billgilbert7000/4164-41256-tester/README.md

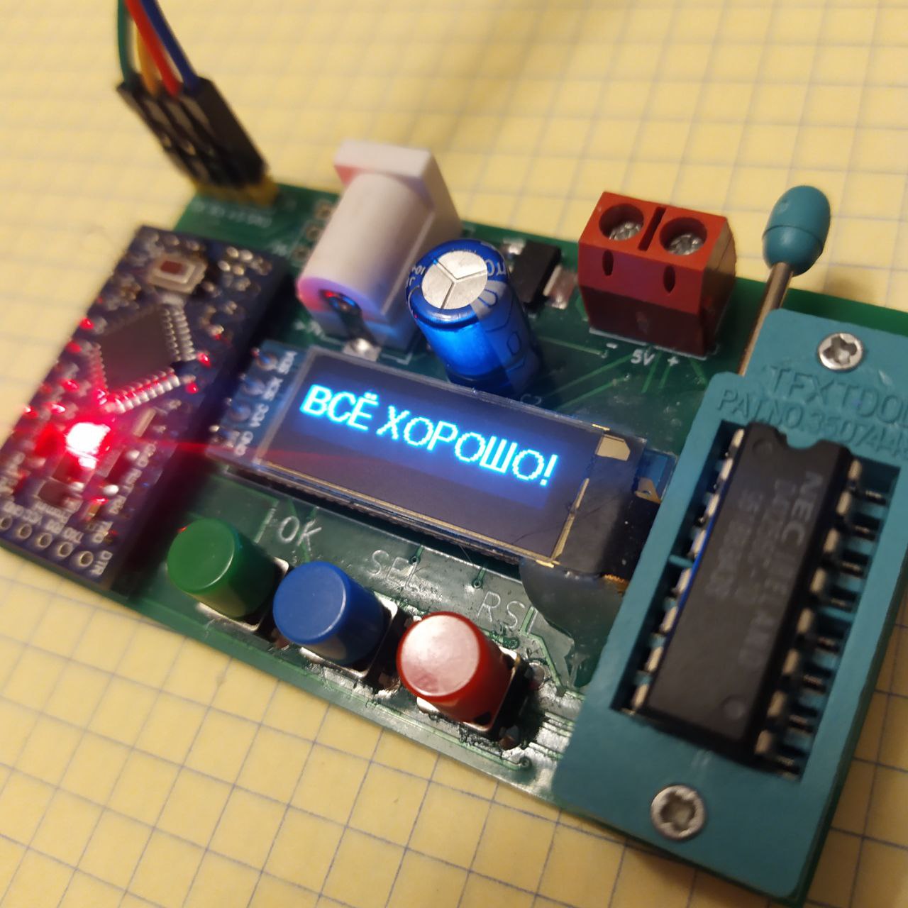
[picture p1: pics/04.jpg]

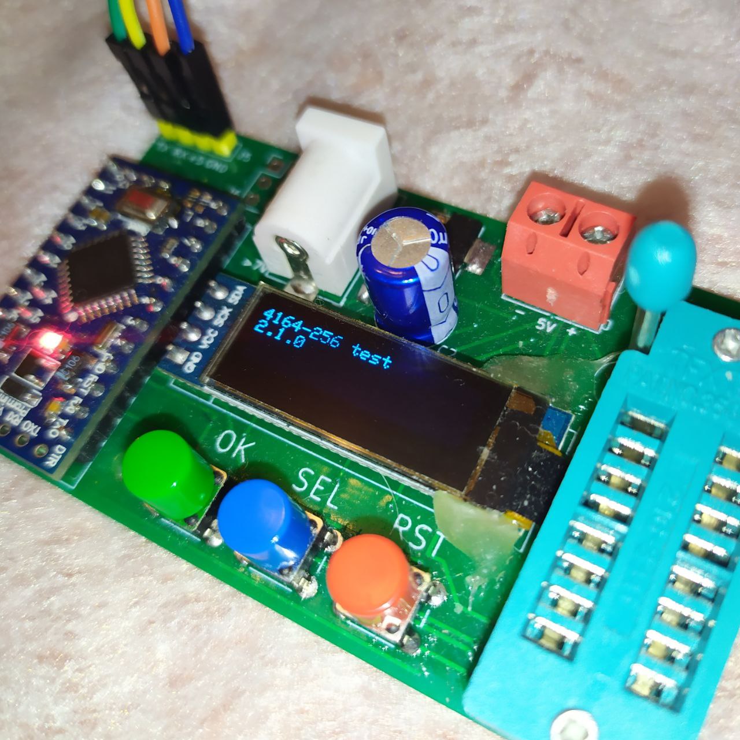
[picture p2: pics/05.jpg]

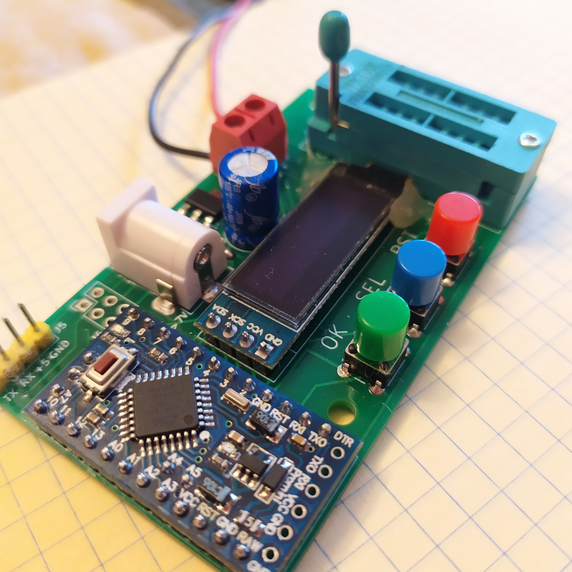
[picture p3: pics/01.jpg]

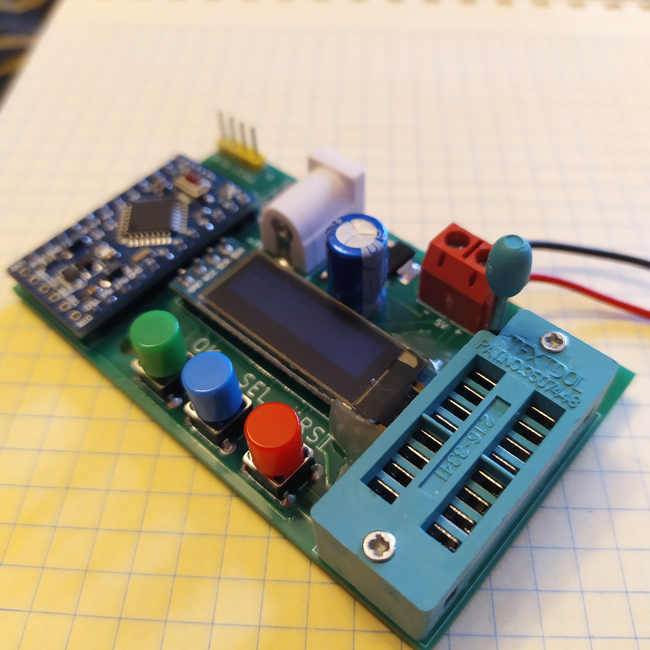
[picture p4: pics/02.jpg]

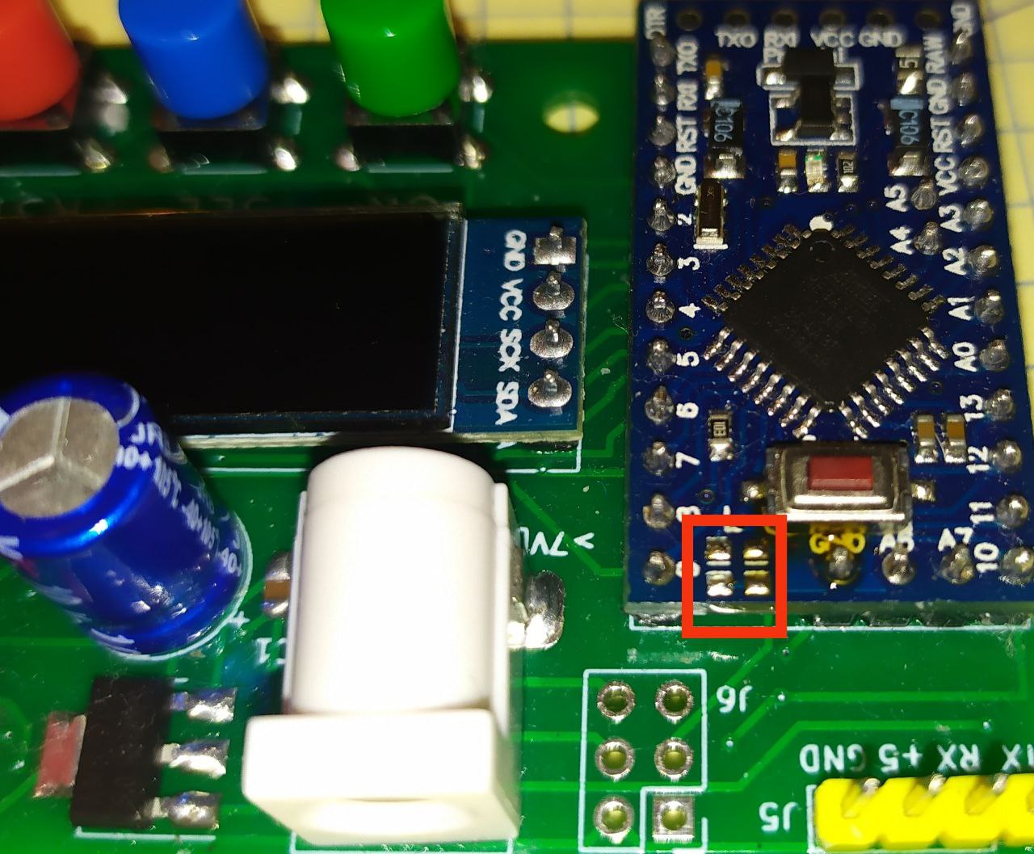
[picture p5: pics/06.jpg]
