billgilbert7000/4164-41256-tester/pics/03.jpg

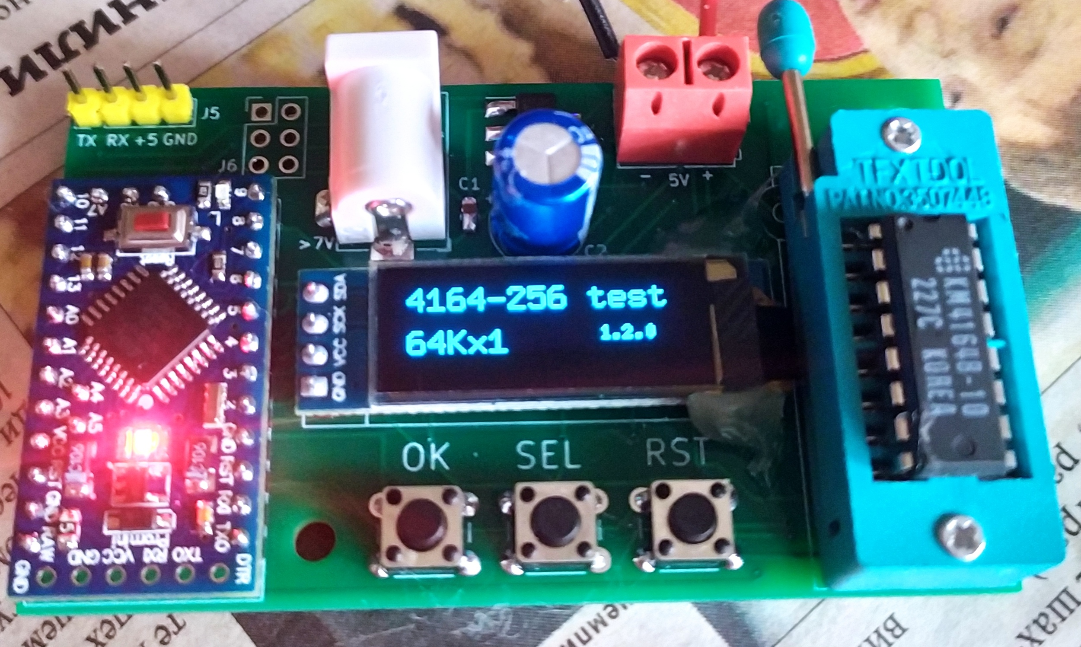
pics/03.jpg
