billgilbert7000/4164-41256-tester/kicad/out/4164-41256-tester.pdf

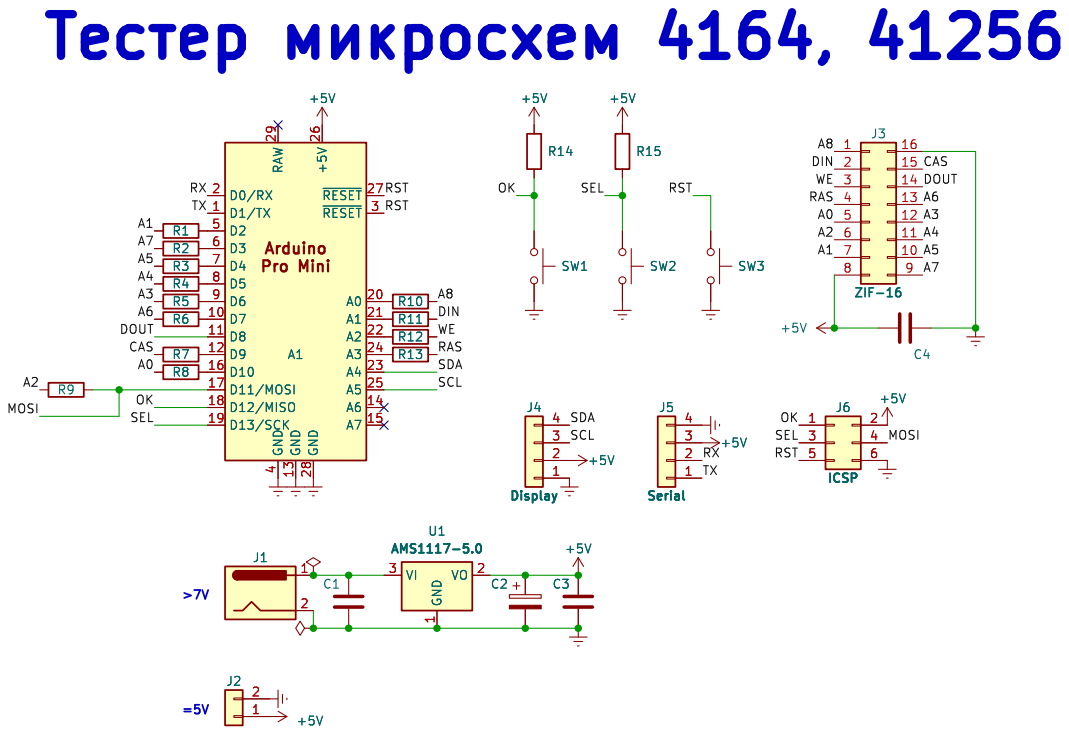
[picture p7: page 1]

File: 4164-41256-tester.kicad_sch Sheet: / https://t.me/emacser2015

Id: 1/1 Title: þÿ"5AB5@ þÿ<8:@>AE5< 4164, 41256
