billgilbert7000/4164-41256-tester/kicad/4164-41256-tester.kicad_pcb

## KiCad design kicad/4164-41256-tester.kicad_pcb (2023-09-10)

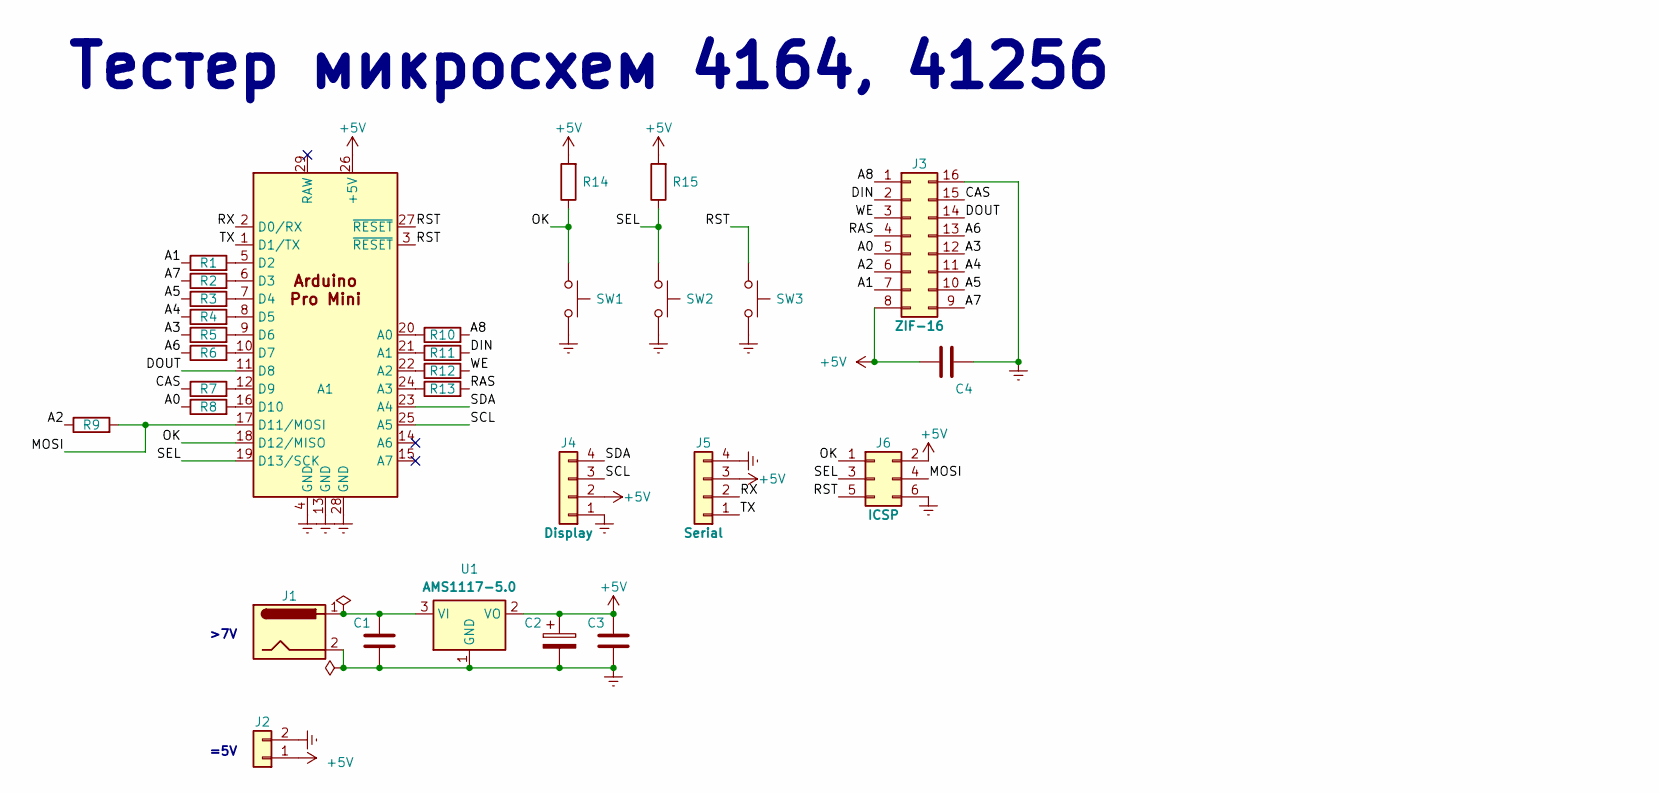
[picture p8: schematic 4164-41256-tester.kicad_sch, Тестер микросхем 4164, 41256]

Parts:
A1: Arduino Pro Mini; arduino_pro_mini
C1, C3, C4: 100 nF; C_0805_2012Metric_Pad1.18x1.45mm_HandSolder
C2: 1000 uF; CP_Radial_D8.0mm_P3.50mm
J1: Jack DC; BarrelJack_Horizontal
J2: PCB Terminal Block; DG301-5.0-2P-1X
J3: ZIF-16; DIP_Socket-16_W4.3_W5.08_W7.62_W10.16_W10.9_3M_216-3340-00-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
J4: Display; SSD1306-0.91-OLED-4pin-128x32
J5: Serial; PinHeader_1x04_P2.54mm_Vertical
J6: ICSP; PinHeader_2x03_P2.54mm_Vertical
R1, R2, R3, R4, R5, R6, R7, R8, R9, R10, R11, R12, R13: 47; R_0805_2012Metric_Pad1.20x1.40mm_HandSolder
R14, R15: 10K; R_0805_2012Metric_Pad1.20x1.40mm_HandSolder
SW1, SW2, SW3: SW Push; SW_PUSH_6mm
U1: AMS1117-5.0; SOT-223-3_TabPin2

Connections:
+5V: A1.26 (+5V), C2.1, C3.1, C4.1, J2.1, J3.8, J4.2, J5.3, J6.2, R14.2, R15.2, U1.2 (VO)
/A0: J3.5, R8.1
/A1: J3.7, R1.1
/A2: J3.6, R9.1
/A3: J3.12, R5.1
/A4: J3.11, R4.1
/A5: J3.10, R3.1
/A6: J3.13, R6.1
/A7: J3.9, R2.1
/A8: J3.1, R10.2
/CAS: J3.15, R7.1
/DIN: J3.2, R11.2
/DOUT: A1.11 (D8), J3.14
/MOSI: A1.17 (D11/MOSI), J6.4, R9.2
/OK: A1.18 (D12/MISO), J6.1, R14.1, SW1.1
/RAS: J3.4, R13.2
/RST: A1.3 (~RESET), A1.27 (~RESET), J6.5, SW3.1
/RX: A1.2 (D0/RX), J5.2
/SCL: A1.25 (A5), J4.3
/SDA: A1.23 (A4), J4.4
/SEL: A1.19 (D13/SCK), J6.3, R15.1, SW2.1
/TX: A1.1 (D1/TX), J5.1
/WE: J3.3, R12.2
Earth: A1.4 (GND), A1.13 (GND), A1.28 (GND), C1.2, C2.2, C3.2, C4.2, J1.2, J2.2, J3.16, J4.1, J5.4, J6.6, SW1.2, SW2.2, SW3.2, U1.1 (GND)
unnamed: A1.20 (A0), R10.1
unnamed: A1.21 (A1), R11.1
unnamed: A1.22 (A2), R12.1
unnamed: A1.24 (A3), R13.1
unnamed: A1.5 (D2), R1.2
unnamed: A1.6 (D3), R2.2
unnamed: A1.7 (D4), R3.2
unnamed: A1.8 (D5), R4.2
unnamed: A1.9 (D6), R5.2
unnamed: A1.10 (D7), R6.2
unnamed: A1.12 (D9), R7.2
unnamed: A1.16 (D10), R8.2
unnamed: C1.1, J1.1, U1.3 (VI)

Notes on the sheet:
=5V
Тестер микросхем 4164, 41256
>7V

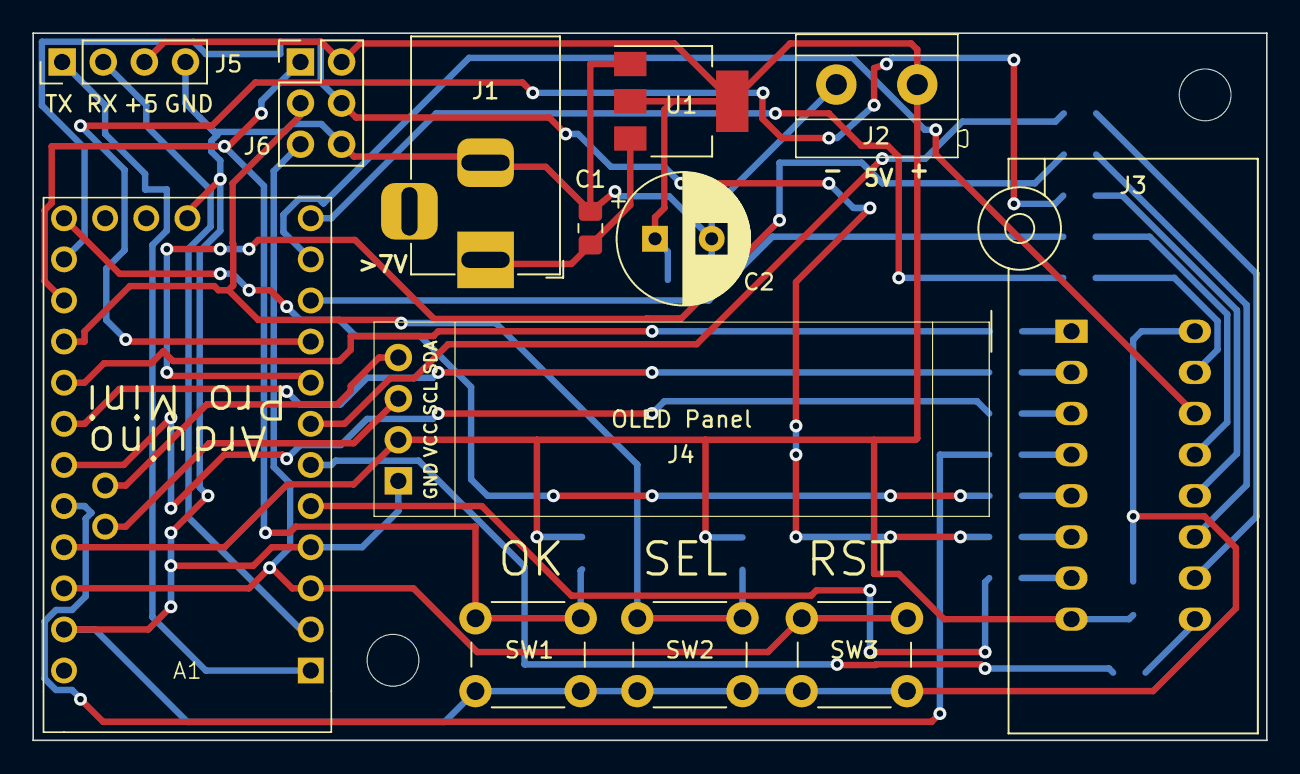
[picture p9: board 4164-41256-tester.kicad_pcb from above]

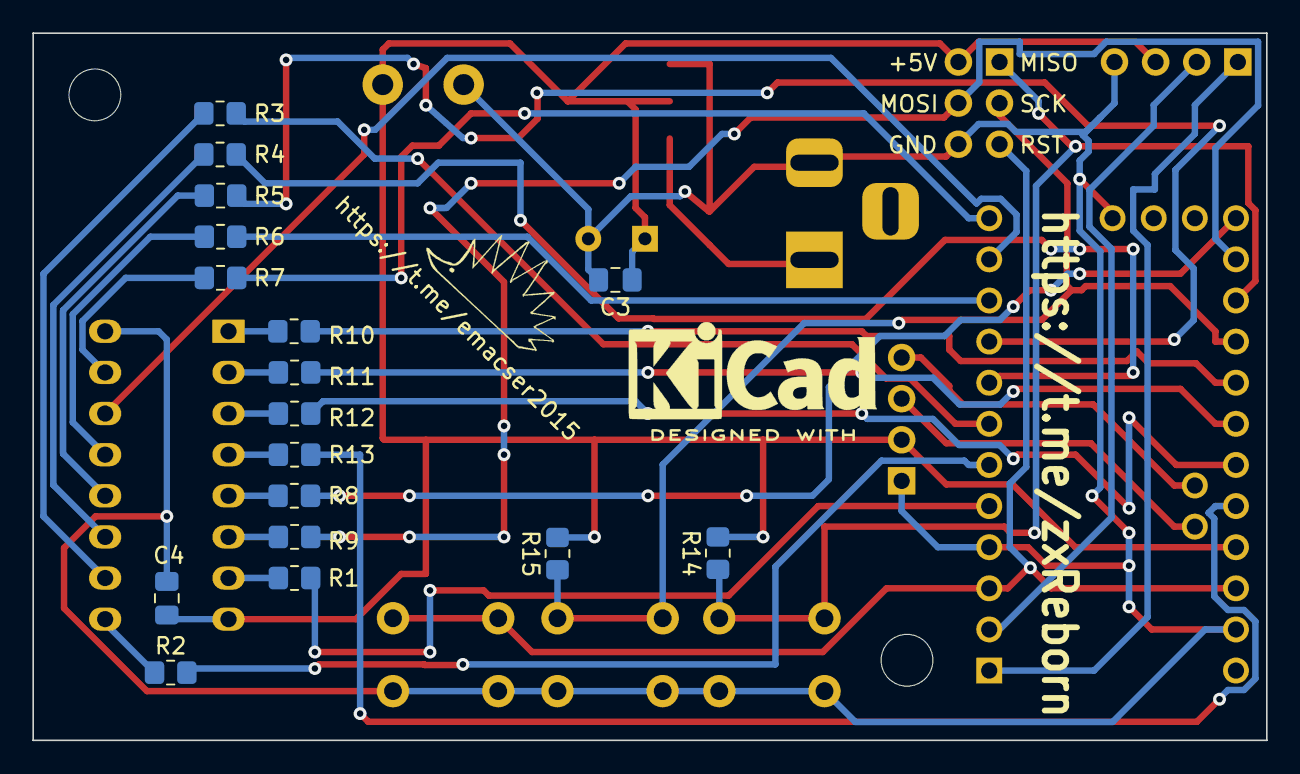
[picture p10: board 4164-41256-tester.kicad_pcb from below]

Board: 2 copper layers, 76.2 x 43.7 mm, 30 parts (17 on the bottom side), 37 nets.
