billgilbert7000/4164-41256-tester/arduino/4164-41256-tester/Config.hpp

#ifndef __CONFIG_HPP__
#define __CONFIG_HPP__

#define NAME        "4164-256 test"
#define VERSION     "2.1.0"

#define DI          15  // PC1
#define DO           8  // PB0
#define CAS          9  // PB1
#define RAS         17  // PC3
#define WE          16  // PC2

#define XA0         10  // PC4
#define XA1          2  // PD2
#define XA2         11  // PC5
#define XA3          6  // PD6
#define XA4          5  // PD5
#define XA5          4  // PD4
#define XA6          7  // PD7
#define XA7          3  // PD3
#define XA8         14  // PC0

#define M_START     12  // Start/mode 
// #define BUS_SIZE     9

#define SEL_BUTTON  13
#define OK_BUTTON   12

#endif // __CONFIG_HPP__
