billgilbert7000/4164-41256-tester/arduino/4164-41256-tester/Executor.cpp

//
// Copyright (c) 2023 Boris Popov <popov@whitekefir.ru>
//

#include "Executor.hpp"
#include <Arduino.h>

Executor::Executor(Out& o, Buttons& b):
     out(o),
     btns(b)
{
     return;
}

void Executor::go(MenuItem::item_t item) {
     if (item == MenuItem::_about) return about();
     bus_size = BUS_SIZE;
     if (item != MenuItem::_256k) --bus_size;
     set_mode(item);
     is_error = false;
     test();
     btns.wait_ok();
}

void Executor::test() {
     init_dram();

     out.clear();
     out.cursor(20);
     out.println("Тест: 0101...");
     out.display();

     fillx(0);
     if (is_error) return;

     out.clear();
     out.cursor(20);
     out.println("Тест: 1010...");
     out.display();

     fillx(1);
     if (is_error) return;

     out.clear();
     out.cursor(20);
     out.println("Пишем 1111...");
     out.display();

     fill(1, false);
     if (is_error) return;

     out.clear();
     out.cursor(20);
     out.println("Проверяем");
     out.display();

     readonly(1);
     if (is_error) return;

     out.clear();
     out.cursor(20);
     out.println("Тест: 0000...");
     out.display();

     fill(0, true);
     if (is_error) return;

     out.clear();
     out.cursor(20);
     out.println_w_yo("ВСЁ ХОРОШО!");
     out.display();
}

void Executor::about() {
     out.clear();
     out.font(Small);
     out.cursor(0);
     out.println(NAME);
     out.println(VERSION);
     out.display();
     btns.wait_ok();
}

void Executor::init() {
     for (u8 i = 0; i < BUS_SIZE; i++)
	  pinMode(a_bus[i], OUTPUT);

     pinMode(CAS, OUTPUT);
     pinMode(RAS, OUTPUT);
     pinMode(WE, OUTPUT);
     pinMode(DI, OUTPUT);
     pinMode(M_START, INPUT);
     pinMode(DO, INPUT);

     digitalWrite(WE, HIGH);
     digitalWrite(RAS, HIGH);
     digitalWrite(CAS, HIGH);
}

void Executor::init_dram() {
     _delay_us(250); // Initial DRAM startup delay 250us
     for (u8 i = 0; i < 8; i++) digitalWrite(a_bus[i], LOW);

     for (u8 i = 0; i < 8; i++)  {
	  digitalWrite(RAS, LOW);
	  digitalWrite(RAS, HIGH);
     }
}

void Executor::fillx(int v) {
     int r, c;
     int nocol = 0;
     if (mode > 1) nocol = 1;
     for (c = 0; c < (1 << bus_size - nocol); c++) {
	  for (r = 0; r < (1 << bus_size); r++) {
	       write_address(r, c, v);
	       if (v != read_address(r, c)) {
		    error(r, c);
		    return;
	       }
	       v ^= 1;
	  }
     }
}

void Executor::fill(int v, bool rd) {
     int r, c;
     int nocol = 0;
     if (mode > 1) nocol = 1;
     for (c = 0; c < (1 << bus_size-nocol); c++) {
	  for (r = 0; r < (1 << bus_size); r++) {
	       write_address(r, c, v);
	       if (rd) {
		    if (v != read_address(r, c)) {
			 error(r, c);
			 return;
		    }
	       }
	  }
     }
}

void Executor::error(int r, int c) {
     unsigned long a = ((unsigned long)c << bus_size) + r;
     String mhex = String(a, HEX);

     out.clear();
     out.font(Regular);
     out.cursor(15);
     out.print("Ошибка ");
     out.font(Small);
     out.cursor(25);
     out.print(mhex.c_str());
     out.display();

     is_error = true;
}

int Executor::read_address(unsigned int r, unsigned int c) {
     int ret = 0;

     // row
     set_bus(r);
     digitalWrite(RAS, LOW);
     // col
     set_bus(c);
     if (mode == 2) digitalWrite(a_bus[7], LOW);
     if (mode == 3) digitalWrite(a_bus[7], HIGH);
     digitalWrite(CAS, LOW);
     // get current value
     ret = digitalRead(DO);

     digitalWrite(CAS, HIGH);
     digitalWrite(RAS, HIGH);
     return ret;
}

void Executor::write_address(unsigned int r, unsigned int c, int v) {
     // row
     set_bus(r);
     digitalWrite(RAS, LOW);
     // rw
     digitalWrite(WE, LOW);
     // val
     digitalWrite(DI, (v & 1) ? HIGH : LOW);
     // col
     set_bus(c);
     if (mode == 2) digitalWrite(a_bus[7], LOW);
     if (mode == 3) digitalWrite(a_bus[7], HIGH);
     digitalWrite(CAS, LOW);
     digitalWrite(WE, HIGH);
     digitalWrite(CAS, HIGH);
     digitalWrite(RAS, HIGH);
}

void Executor::set_bus(unsigned int a) {
     for (u8 i = 0; i < bus_size; i++) { //cambiato con bus_size piccolo
	  if (bitRead(a, i) == 1) {
	       digitalWrite(a_bus[i], HIGH);
	  } else {
	       digitalWrite(a_bus[i], LOW);
	  }
     }
}

void Executor::readonly(int v) {
     int r, c;
     int nocol = 0;
     if (mode > 1) nocol = 1;
     for (c = 0; c < (1 << bus_size-nocol); c++) {
	  for (r = 0; r < (1 << bus_size); r++) {
	       if (v != read_address(r, c)){
		    error(r, c);
		    return;
	       }
	  }
     }
}

void Executor::set_mode(MenuItem::item_t i) {
     switch (i) {

     case MenuItem::_64k:
	  mode = 1;
	  break;

     case MenuItem::_256k:
	  mode = 0;
	  break;

     case MenuItem::_32k_low:
	  mode = 2;
	  break;

     case MenuItem::_32k_high:
	  mode = 3;
	  break;

     default:
	  mode = 1;
     }
}
