billgilbert7000/4164-41256-tester/arduino/4164-41256-tester/Buttons.cpp

//
// Copyright (c) 2023 Boris Popov <popov@whitekefir.ru>
//

#include "Buttons.hpp"
#include <Arduino.h>
#include <stddef.h>

Button* Buttons::poll() {
     if (sel.status() == Button::Release) return &sel;
     if (ok.status() == Button::Release) return &ok;
     return NULL;
}

void Buttons::wait_ok() {
     while (ok.status() != Button::Release) {
	  delay(100);
     }
}
