billgilbert7000/4164-41256-tester/arduino/4164-41256-tester/OkButton.hpp

//
// Copyright (c) 2023 Boris Popov <popov@whitekefir.ru>
//

#include "Button.hpp"

#ifndef _OK_BUTTON_HPP_
#define _OK_BUTTON_HPP_

class OkButton : public Button {

public:
     OkButton();
};
#endif // _OK_BUTTON_HPP_
