billgilbert7000/4164-41256-tester/arduino/4164-41256-tester/SelButton.hpp

//
// Copyright (c) 2023 Boris Popov <popov@whitekefir.ru>
//

#include "Button.hpp"

#ifndef _SEL_BUTTON_HPP_
#define _SEL_BUTTON_HPP_

class SelButton : public Button {

public:
     SelButton();
};
#endif // _SEL_BUTTON_HPP_
