billgilbert7000/4164-41256-tester/(commit log)

2023-09-03 init commit
    [4164-41256-tester.kicad_pcb, 4164-41256-tester.kicad_sch]
2023-09-10 add ibom
    [4164-41256-tester.kicad_pcb, 4164-41256-tester.kicad_sch]
2023-09-16 add gerbers
2023-10-21 add impl for Buttons::wait_ok
2023-10-21 add impl for Executor::error
    [Executor.cpp, Executor.hpp]
